Domochip/WirelessLight/box/WirelessLight v1.1 box.stl

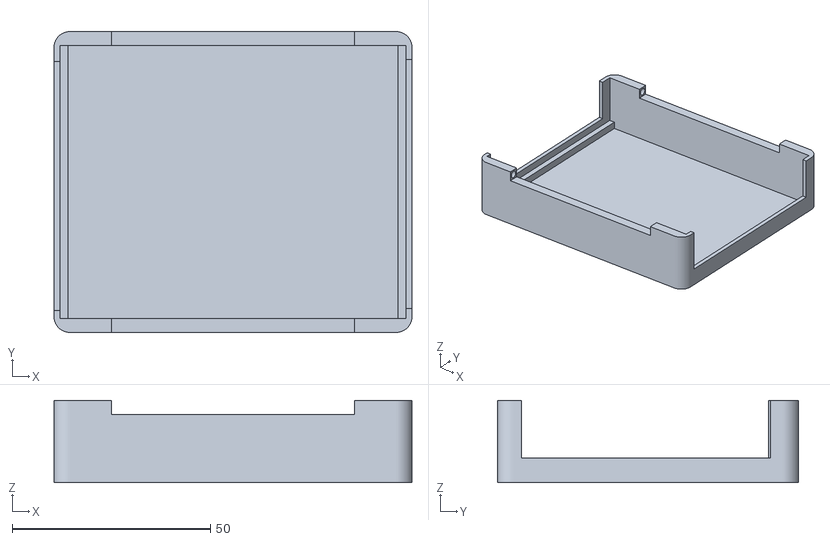
[picture p1: CAD file, 2019-03-17]
box/WirelessLight v1.1 box.stl
90.4 x 75.9 x 20.8
