Domochip/WirelessLight/box/WirelessLight.scad

use <utils/build_plate.scad>

//WirelessLight box
//V1.1

_part = "lid"; // [box, lid, both]

_innerDimensions = true;

WLightNB = 2;

//PCB dimensions
_pcbX = 86.36;
_pcbY = 67.945;

// width of the box (affects the length of the hinges)
_width = _pcbX+1;

// length of the box
_length = _pcbY+1;

// height of the box
_height = 19.5;

// rounding radius of the corners of the box
_rounding = 4;

// thickness of the walls around the magnets
_minimumWallThickness = 0.5;

// thickness of the side walls without the hinge
_sidewallThickness = 1.5;

// thickness of the bottom of the box or the top of the lid
_horizontalThickness = 1.25;

// diameter of magnets in the hinge
_magnetDiameter = 2.5;

// height magnets in the hinge
_magnetHeight = 10.5;

// gap bewteen the lid and box parts
_hingeGap = 0.4;

// Size of lid's spheres that go into box holes
_hingeOverlap = 0.25;

_lidRadius = 0;

module roundRect(width, depth, height, round) {
	round = min(round, width/2);
	linear_extrude(height=height,center=true) offset(r=round) square([width-2*round,depth-2*round],center=true);
}

module roundRectFillet(width, depth, height, round, radius) {
    
    radius=max(0.00001,radius);
    
    minkowski(){
        union(){
            
            translate([0,0,(height-radius)/2])cylinder(r=radius,h=height-radius,center=true);
                
            translate([0,0,height-(radius>height?height:radius)])
            resize([0,0,radius>height?height:0])
            difference(){
                sphere(r=radius, center=true);
                translate([0,0,-radius/2]) cube([2*radius,2*radius,radius],center=true);
            }
        }
    
        roundRect(width-(2*radius),depth-(2*radius),0.000001,round);
    }
}

module makeBase(width, depth, height, rounding, minimum, side, bottom, mdiameter, mheight, gap) {
	eps = 0.1;
	iwidth = width - side*2;
	idepth = depth - mdiameter*2 - minimum*4;
	hingeCutZ = mdiameter + minimum*2/* + gap*/;
	hingeCutWidth = width - rounding*2 - mheight*2;
	fillet = mdiameter/2 + minimum;

    union(){
        difference() {
            translate([0,0,height/2]) 
            difference() {
                roundRect(width, depth, height, rounding);
                translate([0,0,bottom]) {
                    //roundRect(iwidth, idepth, height, rounding-side);
                    cube(size=[iwidth, idepth, height],center=true);
                }
            }
            
    
            // hinge cutout
            translate([0,0,height - hingeCutZ/2 + eps/2]) {
                cube(size=[hingeCutWidth, depth+eps, hingeCutZ + eps], center=true);
            }
            
            // sphere cutout
            for (x=[-1,1])
            for (y=[-1,1]) {
                translate([x * (hingeCutWidth/2 - eps/2), y*(depth/2 - minimum - mdiameter/2), height - minimum - mdiameter/2])
                sphere(d=mdiameter);
            }

            //WirelessLight bornier Cutout
            //input and power
            translate([-iwidth/2-1.7,-_pcbY/2+1.5,bottom+5]) cube([2,_pcbY-1.5-3.5,20]);

            //output
            translate([iwidth/2-0.3,-idepth/2+2.5,bottom+5])cube([2,_pcbY-2.5-2.5,20]);
        }

        //WirelessLight additions
        translate([-iwidth/2,-idepth/2,bottom])cube([2,idepth,2.5]);
        translate([iwidth/2-2,-idepth/2,bottom])cube([2,idepth,2.5]);

    }
}


module makeLid(width, depth, rounding, minimum, side, bottom, mdiameter, mheight, gap, overlap) {
	eps = 0.1;
	hingeWidth = width - rounding*2 - mheight*2 - gap*2;
	hingeSize = mdiameter + minimum*2;
    
    //WirelessDS18B20
    idepth = depth - mdiameter*2 - minimum*4;
	
	difference() {
		union() {
			translate([0,0,bottom/2]) {
				roundRect(width, depth, bottom, rounding);
			}	

			// hinges
			for (s=[-1,1]) {
				translate([0,s*(depth/2 - hingeSize/2),bottom + hingeSize/2]) {
					hull() {
						rotate([0,90,0]) {
							cylinder(r=hingeSize/2, h=hingeWidth,center=true);
						}
						translate([0,s*-hingeSize/4,0]) {
							cube(size=[hingeWidth, hingeSize/2, hingeSize], center=true);
						}
						translate([0,0,-hingeSize/4-eps]) {
							cube(size=[hingeWidth, hingeSize, hingeSize/2], center=true);
						}
					}
				}
			}
            // sphere additions
            for (x=[-1,1])
            for (y=[-1,1]) {
                translate([x * (hingeWidth/2 - eps), y*(depth/2 - minimum - mdiameter/2), mdiameter/2 + bottom + minimum]){
                    difference(){
                        sphere(d=mdiameter);
                        translate([x*(mdiameter/2+eps+gap+overlap),0,0]) cube([mdiameter,mdiameter,mdiameter],center=true);
                    }
                }
            }
            
            //WirelessLight Additions
            //buttons
            translate([-8.89,-25.265,0])cylinder(d=6.5,h=11.5+bottom);
            translate([-8.89,-15.105,0])cylinder(d=6.5,h=11.5+bottom);

            //Protection
            //Inputs
            translate([hingeWidth/2-1.25,-idepth/2,0]) cube([1.25,idepth,11.5+bottom]);
            //Outputs
            translate([-hingeWidth/2,-idepth/2,0]) cube([1.25,idepth,11.5+bottom]);
		}

        //WirelessLight cutouts
        //Connectors
        //Inputs
        translate([hingeWidth/2,-depth/2,-0.1]) cube([(width-hingeWidth)/2,depth,bottom+0.2]);
        //outputs
        translate([-width/2,-depth/2,-0.1]) cube([(width-hingeWidth)/2,depth,bottom+0.2]);

        //buttons
        translate([-8.89,-25.265,0])cylinder(d=4,h=11.5+bottom);
        translate([-8.89,-15.105,0])cylinder(d=4,h=11.5+bottom);

        //WirelessLight Texts
        //Bouttons
        translate([-5,-23.5,0.5])rotate([0,-180,-180])difference(){
            linear_extrude(0.6)offset(r=0.6)text(text="RST",font="Liberation Sans:style=Bold",size=3,halign="left");
            linear_extrude(0.6)text(text="RST",font="Liberation Sans:style=Bold",size=3,halign="left");
        }
        translate([-5,-13.2,0.5])rotate([0,-180,-180])difference(){
            linear_extrude(0.6)offset(r=0.6)text(text="RSC",font="Liberation Sans:style=Bold",size=3,halign="left");
            linear_extrude(0.6)text(text="RSC",font="Liberation Sans:style=Bold",size=3,halign="left");
        }

        //PWR
        translate([20,25.5,0.5])rotate([0,-180,-90])difference(){
            linear_extrude(0.6)offset(r=0.7)text(text="N  P",font="Liberation Sans:style=Bold",size=5,halign="center");
            linear_extrude(0.6)text(text="N  P",font="Liberation Sans:style=Bold",size=5,halign="center");
        }

        //Inputs
        translate([14,-10,0.5])rotate([0,-180,-90])difference(){
            linear_extrude(0.6)offset(r=0.7)text(text="Input",font="Liberation Sans:style=Bold",size=5,halign="center");
            linear_extrude(0.6)text(text="Input",font="Liberation Sans:style=Bold",size=5,halign="center");
        }
        translate([22,-27.5,0.5])rotate([0,-180,-90])difference(){
            linear_extrude(0.6)offset(r=0.7)text(text="1  2",font="Liberation Sans:style=Bold",size=5,halign="center");
            linear_extrude(0.6)text(text="1  2",font="Liberation Sans:style=Bold",size=5,halign="center");
        }
        translate([22,-10,0.5])rotate([0,-180,-90])difference(){
            linear_extrude(0.6)offset(r=0.7)text(text="3  4",font="Liberation Sans:style=Bold",size=5,halign="center");
            linear_extrude(0.6)text(text="3  4",font="Liberation Sans:style=Bold",size=5,halign="center");
        }
        translate([22,7.5,0.5])rotate([0,-180,-90])difference(){
            linear_extrude(0.6)offset(r=0.7)text(text="5  6",font="Liberation Sans:style=Bold",size=5,halign="center");
            linear_extrude(0.6)text(text="5  6",font="Liberation Sans:style=Bold",size=5,halign="center");
        }

        //Output
        translate([-19,-10,0.5])rotate([0,-180,-90])difference(){
            linear_extrude(0.6)offset(r=0.7)text(text="Output",font="Liberation Sans:style=Bold",size=5,halign="center");
            linear_extrude(0.6)text(text="Output",font="Liberation Sans:style=Bold",size=5,halign="center");
        }
        translate([-27,-27.5,0.5])rotate([0,-180,-90])difference(){
            linear_extrude(0.6)offset(r=0.7)text(text="1  2",font="Liberation Sans:style=Bold",size=5,halign="center");
            linear_extrude(0.6)text(text="1  2",font="Liberation Sans:style=Bold",size=5,halign="center");
        }
        translate([-27,-10,0.5])rotate([0,-180,-90])difference(){
            linear_extrude(0.6)offset(r=0.7)text(text="3  4",font="Liberation Sans:style=Bold",size=5,halign="center");
            linear_extrude(0.6)text(text="3  4",font="Liberation Sans:style=Bold",size=5,halign="center");
        }
        translate([-27,7.5,0.5])rotate([0,-180,-90])difference(){
            linear_extrude(0.6)offset(r=0.7)text(text="5  6",font="Liberation Sans:style=Bold",size=5,halign="center");
            linear_extrude(0.6)text(text="5  6",font="Liberation Sans:style=Bold",size=5,halign="center");
        }

        //Brand :-)
        translate([-3.5,-3,0.5])rotate([0,-180,-90])difference(){
            linear_extrude(0.6)offset(r=0.7)text(text="WLight",font="Liberation Sans:style=Bold",size=7,halign="left");
            linear_extrude(0.6)text(text="WLight",font="Liberation Sans:style=Bold",size=7,halign="left");
        }
	}

}

module make($fn=60) {
	// minimal error checking
	eps = 0.1;
    
	rounding = max(_rounding, _sidewallThickness + eps);
	height = max(_height, _horizontalThickness + _magnetDiameter + _minimumWallThickness*2 + _hingeGap);


    //if innerDimensions then recalculate
    if(_innerDimensions == true){
        
        width=_width+2*_sidewallThickness;
        length=_length+2*(_magnetDiameter+2*_minimumWallThickness);
        height=height+_horizontalThickness;
        
        if (_part == "box" || _part == "both") {
            makeBase(width, length, height, rounding, 
                        _minimumWallThickness, _sidewallThickness, _horizontalThickness, 
                        _magnetDiameter, _magnetHeight, _hingeGap);
        }
        if (_part == "lid" || _part == "both") {
            translate([0,0,height+_horizontalThickness+0.1]) rotate([0,180,0]) makeLid(width, length, rounding, 
                        _minimumWallThickness, _sidewallThickness, _horizontalThickness, 
                        _magnetDiameter, _magnetHeight, _hingeGap, _hingeOverlap);
        }
    }
    else{
        if (_part == "box" || _part == "both") {
            makeBase(_width, _length, height, rounding, 
                        _minimumWallThickness, _sidewallThickness, _horizontalThickness, 
                        _magnetDiameter, _magnetHeight, _hingeGap);
        }
        if (_part == "lid" || _part == "both") {
            translate([0,0,height+_horizontalThickness+0.1]) rotate([0,180,0]) makeLid(_width, _length, rounding, 
                        _minimumWallThickness, _sidewallThickness, _horizontalThickness, 
                        _magnetDiameter, _magnetHeight, _hingeGap, _hingeOverlap);
        }

		
	}

}

build_plate(0);
make();
