Domochip/WirelessLight/schematic/WirelessLight.kicad_pcb

## KiCad design schematic/WirelessLight.kicad_pcb (2019-03-17)

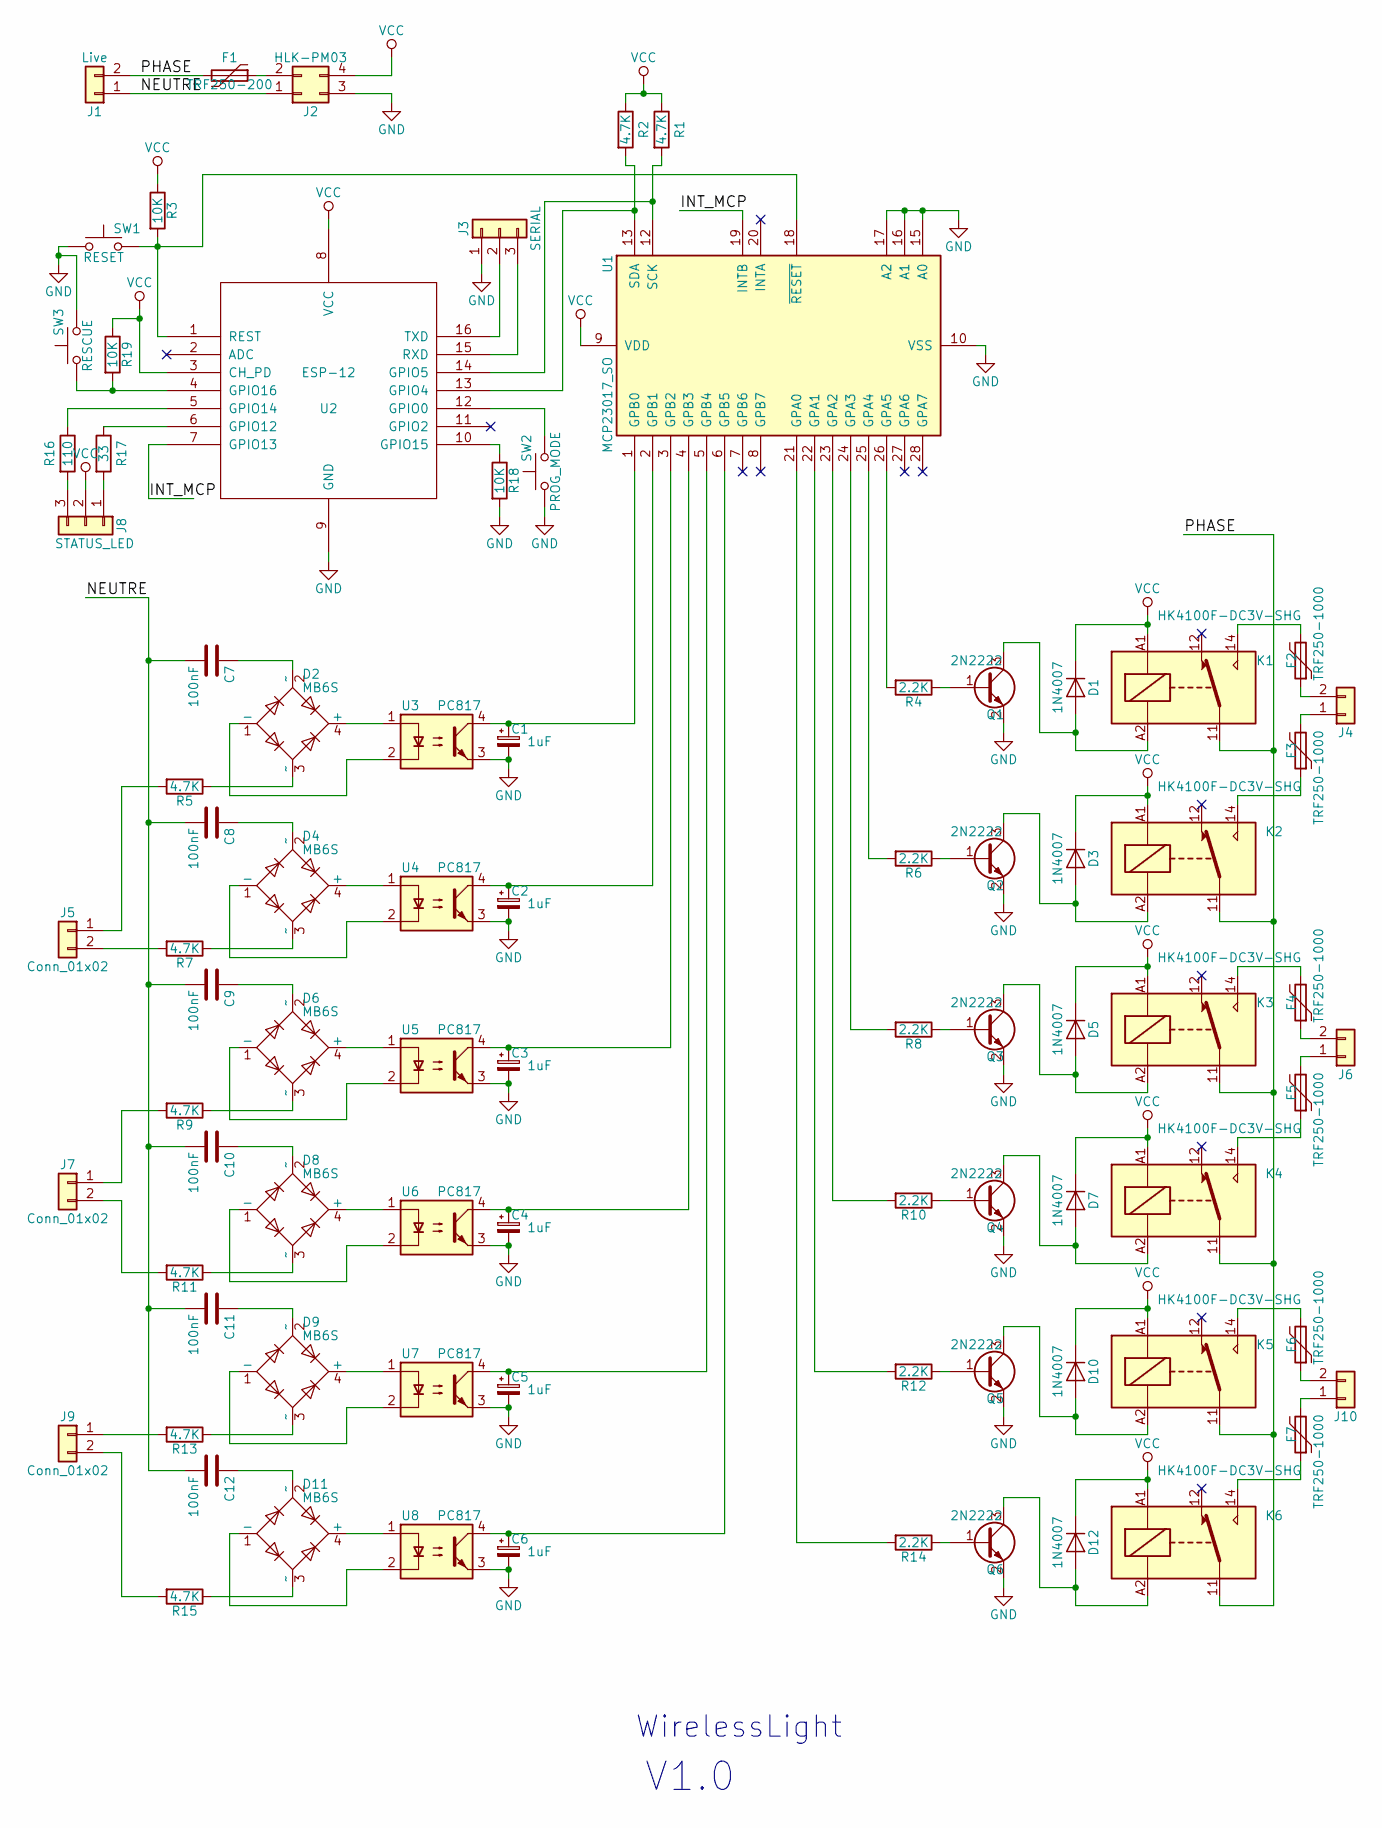
[picture p2: schematic WirelessLight.sch]

Parts:
C1, C2, C3, C4, C5, C6: 1uF; C_0805_HandSoldering
C7, C8, C9, C10, C11, C12: 100nF; C_1812_HandSoldering
D1, D3, D5, D7, D10, D12: 1N4007; D_SMA_Handsoldering
D2, D4, D6, D8, D9, D11: MB6S; TO-269AA
F1: TRF250-200; TRF250-400
F2, F3, F4, F5, F6, F7: TRF250-1000
J1: Live; KF235-2P-3.81
J2: HLK-PM03; HLK-PM01
J3: SERIAL; Pin_Header_Straight_1x03_Pitch2.54mm
J4, J5, J6, J7, J9, J10: Conn_01x02; KF235-2P-3.81
J8: STATUS_LED; Pin_Header_Straight_1x03_Pitch2.54mm
K1, K2, K3, K4, K5, K6: HK4100F-DC3V-SHG; HK4100F
Q1, Q2, Q3, Q4, Q5, Q6: 2N2222; SOT-23_Handsoldering
R1, R2: 4.7K; R_0805_HandSoldering
R3, R18, R19: 10K; R_0805_HandSoldering
R4, R6, R8, R10, R12, R14: 2.2K; R_0805_HandSoldering
R5, R7, R9, R11, R13, R15: 4.7K; R_2010_HandSoldering
R16: 110; R_0805_HandSoldering
R17: 33; R_0805_HandSoldering
SW1: RESET; SW_PUSH_6mm_h5mm
SW2: PROG_MODE; SW_PUSH_6mm_h5mm
SW3: RESCUE; SW_PUSH_6mm_h5mm
U1: MCP23017_SO; SOIC-28W_7.5x17.9mm_Pitch1.27mm
U2: ESP-12
U3, U4, U5, U6, U7, U8: PC817; DIP-4_W8.89mm_SMDSocket_LongPads

Connections:
/INT_MCP: U1.19 (INTB), U2.7 (GPIO13)
/NEUTRE: C7.2, C8.2, C9.2, C10.2, C11.2, C12.2, J1.1, J2.1
/PHASE: F1.2, J1.2, K1.11, K2.11, K3.11, K4.11, K5.11, K6.11
GND: C1.2, C2.2, C3.2, C4.2, C5.2, C6.2, J2.3, J3.1, Q1.2 (E), Q2.2 (E), Q3.2 (E), Q4.2 (E), Q5.2 (E), Q6.2 (E), R18.2, SW1.1, SW2.1, SW3.2, U1.10 (VSS), U1.15 (A0), U1.16 (A1), U1.17 (A2), U2.9 (GND), U3.3, U4.3, U5.3, U6.3, U7.3, U8.3
unnamed: C1.1, U1.1 (GPB0), U3.4
unnamed: C2.1, U1.2 (GPB1), U4.4
unnamed: C3.1, U1.3 (GPB2), U5.4
unnamed: C4.1, U1.4 (GPB3), U6.4
unnamed: C5.1, U1.5 (GPB4), U7.4
unnamed: C6.1, U1.6 (GPB5), U8.4
unnamed: C7.1, D2.2 (~~)
unnamed: C8.1, D4.2 (~~)
unnamed: C9.1, D6.2 (~~)
unnamed: C10.1, D8.2 (~~)
unnamed: C11.1, D9.2 (~~)
unnamed: C12.1, D11.2 (~~)
unnamed: D1.2 (A), K1.A2, Q1.3 (C)
unnamed: D2.1 (-), U3.2
unnamed: D2.3 (~~), R5.1
unnamed: D2.4 (+), U3.1
unnamed: D3.2 (A), K2.A2, Q2.3 (C)
unnamed: D4.1 (-), U4.2
unnamed: D4.3 (~~), R7.1
unnamed: D4.4 (+), U4.1
unnamed: D5.2 (A), K3.A2, Q3.3 (C)
unnamed: D6.1 (-), U5.2
unnamed: D6.3 (~~), R9.1
unnamed: D6.4 (+), U5.1
unnamed: D7.2 (A), K4.A2, Q4.3 (C)
unnamed: D8.1 (-), U6.2
unnamed: D8.3 (~~), R11.1
unnamed: D8.4 (+), U6.1
unnamed: D9.1 (-), U7.2
unnamed: D9.3 (~~), R13.1
unnamed: D9.4 (+), U7.1
unnamed: D10.2 (A), K5.A2, Q5.3 (C)
unnamed: D11.1 (-), U8.2
unnamed: D11.3 (~~), R15.1
unnamed: D11.4 (+), U8.1
unnamed: D12.2 (A), K6.A2, Q6.3 (C)
unnamed: F1.1, J2.2
unnamed: F2.1, J4.2
unnamed: F2.2, K1.14
unnamed: F3.1, K2.14
unnamed: F3.2, J4.1
unnamed: F4.1, J6.2
unnamed: F4.2, K3.14
unnamed: F5.1, K4.14
unnamed: F5.2, J6.1
unnamed: F6.1, J10.2
unnamed: F6.2, K5.14
unnamed: F7.1, K6.14
unnamed: F7.2, J10.1
unnamed: J3.2, U2.16 (TXD)
unnamed: J3.3, U2.15 (RXD)
unnamed: J5.1, R5.2
unnamed: J5.2, R7.2
unnamed: J7.1, R9.2
unnamed: J7.2, R11.2
unnamed: J8.1, R17.2
unnamed: J8.3, R16.2
unnamed: J9.1, R13.2
unnamed: J9.2, R15.2
unnamed: Q1.1 (B), R4.1
unnamed: Q2.1 (B), R6.1
unnamed: Q3.1 (B), R8.1
unnamed: Q4.1 (B), R10.1
unnamed: Q5.1 (B), R12.1
unnamed: Q6.1 (B), R14.1
unnamed: R1.2, U1.12 (SCK), U2.14 (GPIO5)
unnamed: R2.2, U1.13 (SDA), U2.13 (GPIO4)
unnamed: R3.2, SW1.2, U1.18 (~RESET~), U2.1 (REST)
unnamed: R4.2, U1.26 (GPA5)
unnamed: R6.2, U1.25 (GPA4)
unnamed: R8.2, U1.24 (GPA3)
unnamed: R10.2, U1.23 (GPA2)
unnamed: R12.2, U1.22 (GPA1)
unnamed: R14.2, U1.21 (GPA0)
unnamed: R16.1, U2.5 (GPIO14)
unnamed: R17.1, U2.6 (GPIO12)
unnamed: R18.1, U2.10 (GPIO15)
unnamed: R19.2, SW3.1, U2.4 (GPIO16)
unnamed: SW2.2, U2.12 (GPIO0)
VCC: D1.1 (K), D3.1 (K), D5.1 (K), D7.1 (K), D10.1 (K), D12.1 (K), J2.4, J8.2, K1.A1, K2.A1, K3.A1, K4.A1, K5.A1, K6.A1, R1.1, R2.1, R3.1, R19.1, U1.9 (VDD), U2.3 (CH_PD), U2.8 (VCC)

Notes on the sheet:
WirelessLight
V1.0

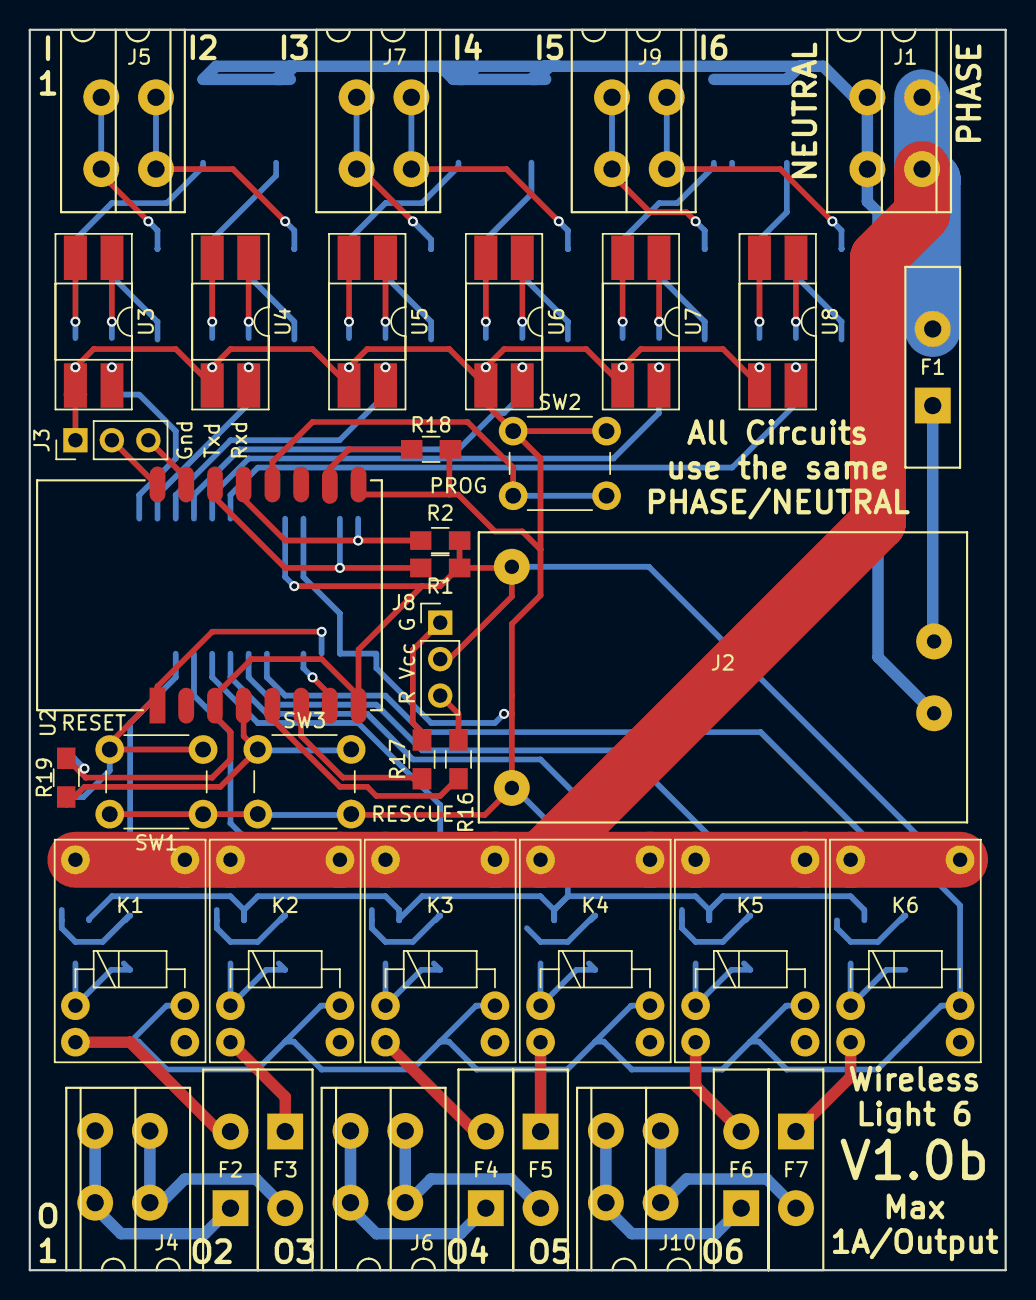
[picture p3: board WirelessLight.kicad_pcb from above]

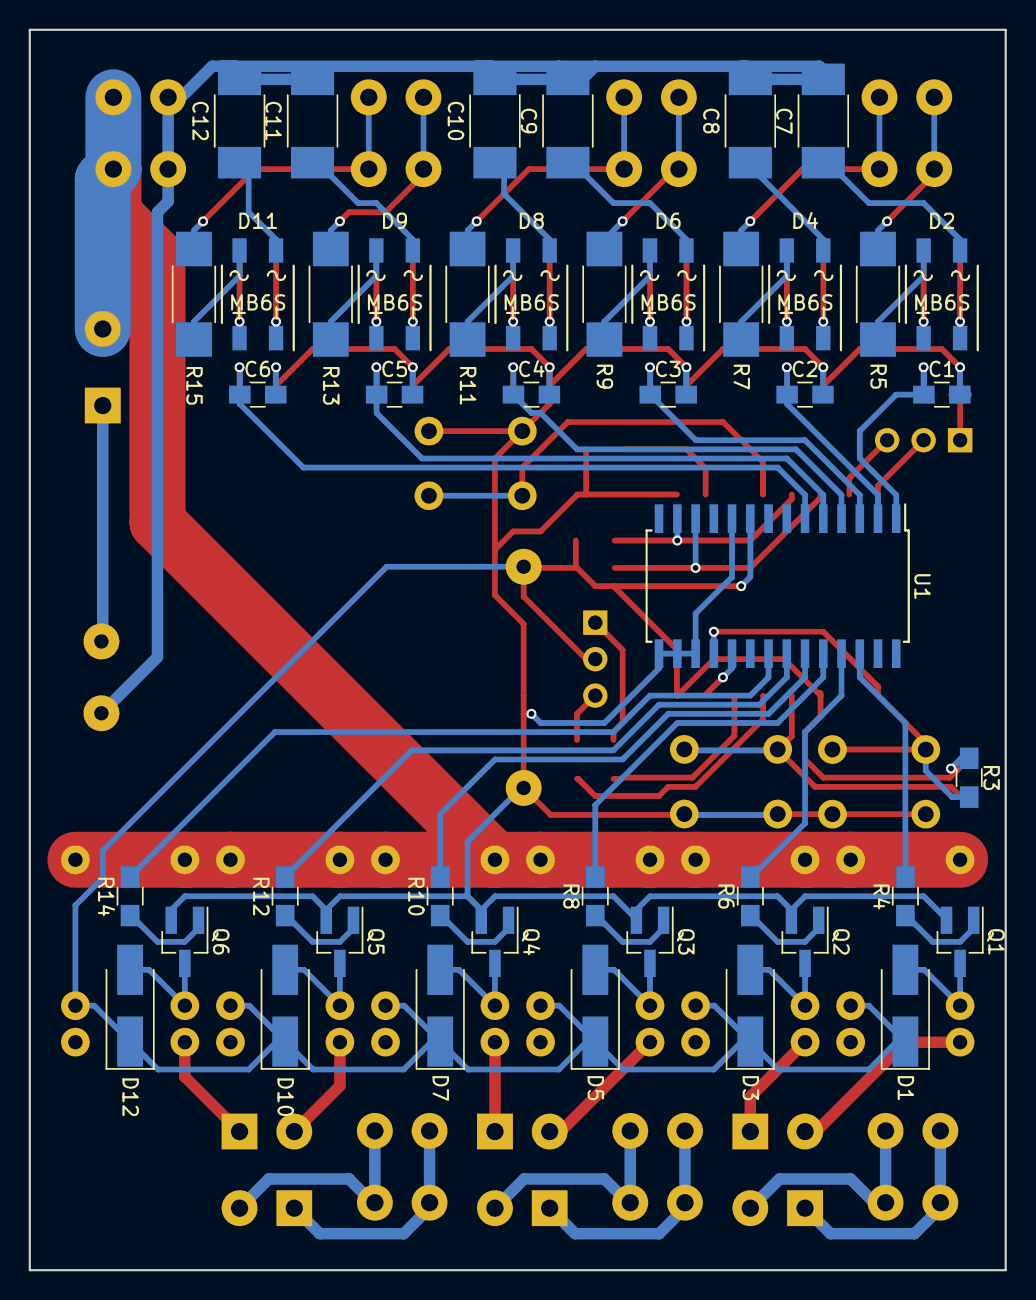
[picture p4: board WirelessLight.kicad_pcb from below]

Board: 2 copper layers, 67.9 x 86.4 mm, 83 parts (44 on the bottom side), 84 nets.
