Domochip/WirelessLight/src/VolatileTicker.h

/* 
  VolatileTicker.h - esp8266 library that calls functions periodically

  Copyright (c) 2014 Ivan Grokhotkov. All rights reserved.
  This file is part of the esp8266 core for Arduino environment.
 
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
  You should have received a copy of the GNU Lesser General Public
  License along with this library; if not, write to the Free Software
  Foundation, Inc., 51 Franklin St, Fifth Floor, Boston, MA  02110-1301  USA
*/

#ifndef VOLATILETICKER_H
#define VOLATILETICKER_H

#include <stdint.h>
#include <stdbool.h>
#include <stddef.h>

extern "C" {
	typedef struct _ETSTIMER_ ETSTimer;
}

class VolatileTicker
{
public:
	VolatileTicker();
	~VolatileTicker();
	typedef void (*callback_t)(void);
	typedef void (*callback_with_arg_t)(void*);

	void attach(float seconds, callback_t callback) volatile
	{
		_attach_ms(seconds * 1000, true, reinterpret_cast<callback_with_arg_t>(callback), 0);
	}

	void attach_ms(uint32_t milliseconds, callback_t callback) volatile
	{
		_attach_ms(milliseconds, true, reinterpret_cast<callback_with_arg_t>(callback), 0);
	}

	template<typename TArg>
	void attach(float seconds, void (*callback)(TArg), TArg arg) volatile
	{
		static_assert(sizeof(TArg) <= sizeof(uint32_t), "attach() callback argument size must be <= 4 bytes");
		// C-cast serves two purposes:
		// static_cast for smaller integer types,
		// reinterpret_cast + const_cast for pointer types
		uint32_t arg32 = (uint32_t)arg;
		_attach_ms(seconds * 1000, true, reinterpret_cast<callback_with_arg_t>(callback), arg32);
	}

	template<typename TArg>
	void attach_ms(uint32_t milliseconds, void (*callback)(TArg), TArg arg) volatile
	{
		static_assert(sizeof(TArg) <= sizeof(uint32_t), "attach_ms() callback argument size must be <= 4 bytes");
		uint32_t arg32 = (uint32_t)arg;
		_attach_ms(milliseconds, true, reinterpret_cast<callback_with_arg_t>(callback), arg32);
	}

	void once(float seconds, callback_t callback) volatile
	{
		_attach_ms(seconds * 1000, false, reinterpret_cast<callback_with_arg_t>(callback), 0);
	}

	void once_ms(uint32_t milliseconds, callback_t callback) volatile
	{
		_attach_ms(milliseconds, false, reinterpret_cast<callback_with_arg_t>(callback), 0);	
	}

	template<typename TArg>
	void once(float seconds, void (*callback)(TArg), TArg arg) volatile
	{
		static_assert(sizeof(TArg) <= sizeof(uint32_t), "attach() callback argument size must be <= 4 bytes");
		uint32_t arg32 = (uint32_t)(arg);
		_attach_ms(seconds * 1000, false, reinterpret_cast<callback_with_arg_t>(callback), arg32);
	}

	template<typename TArg>
	void once_ms(uint32_t milliseconds, void (*callback)(TArg), TArg arg) volatile
	{
		static_assert(sizeof(TArg) <= sizeof(uint32_t), "attach_ms() callback argument size must be <= 4 bytes");
		uint32_t arg32 = (uint32_t)(arg);
		_attach_ms(milliseconds, false, reinterpret_cast<callback_with_arg_t>(callback), arg32);
	}

	void detach() volatile;
	bool active() volatile;

protected:	
	void _attach_ms(uint32_t milliseconds, bool repeat, callback_with_arg_t callback, uint32_t arg) volatile;


protected:
	ETSTimer* _timer;
};


#endif//VOLATILETICKER_H
