Domochip/WirelessLight/(commit log)

2019-03-17 V1.0.7 Initial Commit
    [WirelessLight v1.1 box.stl, WirelessLight.kicad_pcb, WirelessLight.scad, WirelessLight.sch]
2019-11-07 replace Serial by LOG_SERIAL
    [WirelessLight.cpp]
2019-11-07 V1.0.13 Compatibility with Framework 2.5.2!!!
